tal-QSL/DDS_PCB/RF sim files/Sim/FrequencyResponse.jpg

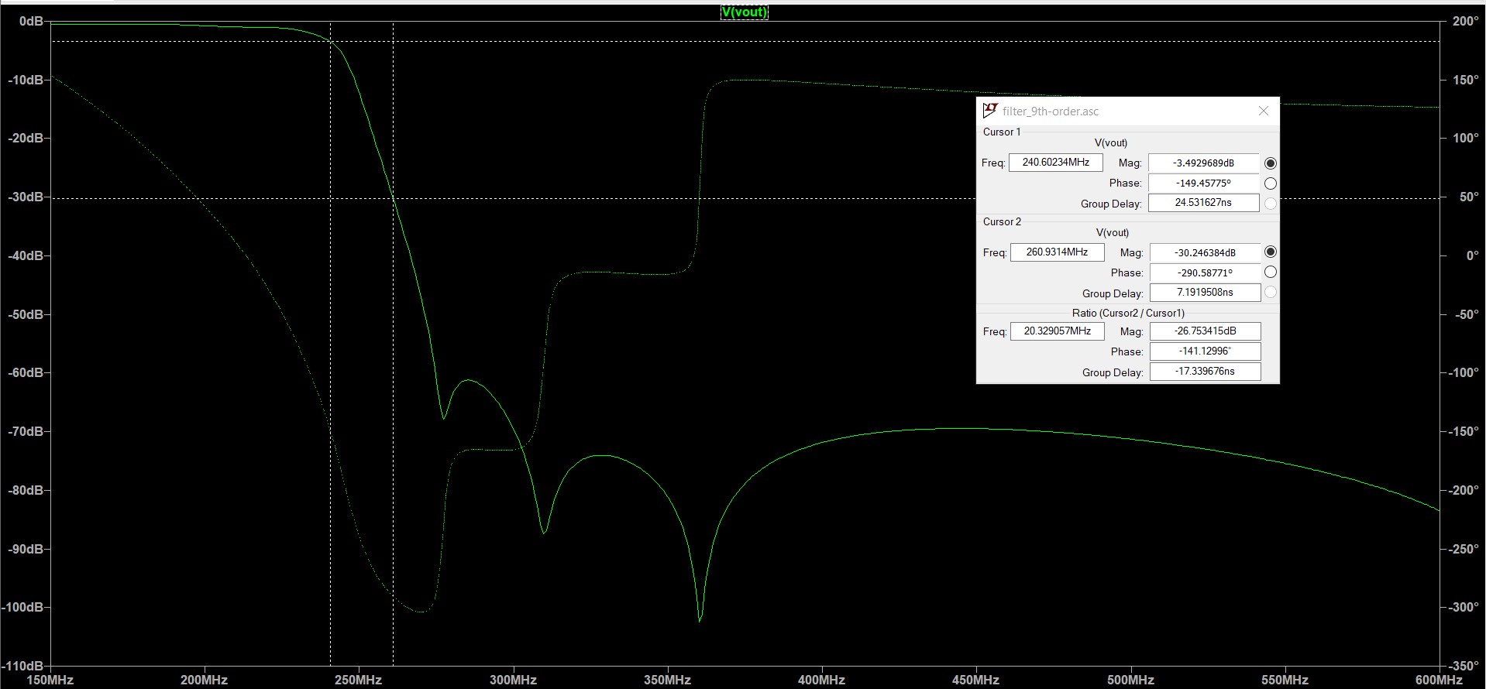
RF sim files/Sim/FrequencyResponse.jpg
