tal-QSL/DDS_PCB/DDS_PCB_BOM.xlsx

Designator | Quantity | Value | Name | Description | Footprint | Manufacturer 1 | Manufacturer Part Number 1 | Manufacturer Lifecycle 1 | Supplier 1 | Supplier Part Number 1 | Supplier Unit Price 1 | Supplier Subtotal 1
C1_M1, C1_M2 | 2 |  | 680pF 50V | CAP CER 680PF 50V NP0 0402 | C0402
C2_M1, C2_M2, C3_M1, C3_M2 | 4 |  | 39pF 50V | CAP CER 39PF 50V NP0 0402 | C0402
C4_M1, C4_M2, C5_M1, C5_M2, C6_M1, C6_M2, C31_A1, C31_A2, C31_A3, C31_A4, C31_A5, C31_A6, C31_A7, C31_A8, C32_A1, C32_A2, C32_A3, C32_A4, C32_A5, C32_A6, C32_A7, C32_A8, C40_A1, C40_A2, C40_A3, C40_A4, C40_A5, C40_A6, C40_A7, C40_A8 | 30 |  | 1uF 25V | CAP CER 1uF 25V X5R 0402 | C0402
C7_M1, C7_M2, C8_M1, C8_M2, C9_M1, C9_M2, C43_M1, C43_M2, C59_M1, C59_M2, C62_M1, C62_M2, C65_M1, C65_M2 | 14 |  | 10uF 10V | CAP CER 10uF 10V X5R 0402 | C0402
C10_M1, C10_M2, C11_M1, C11_M2, C12_M1, C12_M2, C29_LS1, C29_LS2, C29_LS3, C29_LS4, C30_LS1, C30_LS2, C30_LS3, C30_LS4, C38_A1, C38_A2, C38_A3, C38_A4, C38_A5, C38_A6, C38_A7, C38_A8, C39_A1, C39_A2, C39_A3, C39_A4, C39_A5, C39_A6, C39_A7, C39_A8, C41_M1, C41_M2, C42_M1, C42_M2, C57_M1, C57_M2, C58_M1, C58_M2, C60_M1, C60_M2, C61_M1, C61_M2, C63_M1, C63_M2, C64_M1, C64_M2 | 46 |  | 0.1uF 50V | CAP CER 0.1uF 50V NP0 0402 | C0402
C13, C20, C26 | 3 |  | 10uF 25V | CAP CER 10UF 25V 10% X5R 0603 | C0603
C14, C15, C18, C19, C22, C24, C25 | 7 |  | 10nF 25V | CAP CER 10nF 25V 10% X5R 0402 | C0402
C16, C17, C23, C27 | 4 |  | 22uF 16V | CAP CER 22UF 16V 10% X5R 0603 | C0603
C33_A1, C33_A2, C33_A3, C33_A4, C33_A5, C33_A6, C33_A7, C33_A8 | 8 |  | 16pF 50V | CAP CER 16PF 50V 5% NP0 0402 | C0402
C34_A1, C34_A2, C34_A3, C34_A4, C34_A5, C34_A6, C34_A7, C34_A8 | 8 |  | 11pF 50V | CAP CER 11PF 50V 5% NP0 0402 | C0402
C35_A1, C35_A2, C35_A3, C35_A4, C35_A5, C35_A6, C35_A7, C35_A8 | 8 |  | 10pF 50V | CAP CER 10PF 50V 5% NP0 0402 | C0402
C36_A1, C36_A2, C36_A3, C36_A4, C36_A5, C36_A6, C36_A7, C36_A8 | 8 |  | 13pF 50V | CAP CER 13PF 50V 5% NP0 0402 | C0402
C37_A1, C37_A2, C37_A3, C37_A4, C37_A5, C37_A6, C37_A7, C37_A8 | 8 |  | 470pF 25V | CAP CER 470pF 25V X5R 0402 | C0402
F1, F2, F3 | 3 |  | PTC 24V / 1.5A | FUSE PTC 24V 1.5A POLYFUSE 1812 | 1812_F
FB1_M1, FB1_M2, FB2, FB3, FB4, FB5 | 6 |  | BLM18EG221SN1D | FERRITE BEAD 220_OHM@100MHz 0603 2A 50mohm_DC | fb0603
FB6_A1, FB6_A2, FB6_A3, FB6_A4, FB6_A5, FB6_A6, FB6_A7, FB6_A8 | 8 |  | BLM15HD182 | FERRITE BEAD 1.8K OHM 0402 1LN | 0402-A
J1 | 1 |  | 1053141204 | No Description Available | CON_1053141204
J2 | 1 |  | 5767096-1 | CONN MICTOR 38POS .025 VERT SMD | MICTOR-38_PIN
J3, J4, J5 | 3 |  | 90131-0770 | CONN HEADER 20 TH | HEADER_10x2
J6 | 1 |  | 10018784-10201TLF | 64 Position Female Connector PCI Expressâ„¢ Gold 0.039 _1.00mm_ Black | PCIE_8LANE_EDGE
J7_A1, J7_A2, J7_A3, J7_A4, J7_A5, J7_A6, J7_A7, J7_A8 | 8 |  | SMA-J-P-H-RA-TH1 | No Description Available | CONN_SMA-J-P-H-RA-TH1_SAI
J8_A1, J8_A2, J8_A3, J8_A4, J8_A5, J8_A6, J8_A7, J8_A8 | 8 |  | MMCX-J-P-H-ST-TH1 | MMCX STRAIGHT, THROUGH HOLE JACK- 50 OHM | SAMTEC_MMCX-J-P-H-ST-TH1
L1_A1, L1_A2, L1_A3, L1_A4, L1_A5, L1_A6, L1_A7, L1_A8 | 8 | 56nH | Inductor | Inductor | 0402-A
L2_A1, L2_A2, L2_A3, L2_A4, L2_A5, L2_A6, L2_A7, L2_A8, L3_A1, L3_A2, L3_A3, L3_A4, L3_A5, L3_A6, L3_A7, L3_A8 | 16 | 43nH | Inductor | Inductor | 0402-A
L4_A1, L4_A2, L4_A3, L4_A4, L4_A5, L4_A6, L4_A7, L4_A8 | 8 | 47nH | Inductor | Inductor | 0402-A
L5_A1, L5_A2, L5_A3, L5_A4, L5_A5, L5_A6, L5_A7, L5_A8, L7_A1, L7_A2, L7_A3, L7_A4, L7_A5, L7_A6, L7_A7, L7_A8 | 16 | 33nH | Inductor | Inductor | 0402-A
L6_A1, L6_A2, L6_A3, L6_A4, L6_A5, L6_A6, L6_A7, L6_A8 | 8 | 24nH | Inductor | Inductor | 0402-A
L8_A1, L8_A2, L8_A3, L8_A4, L8_A5, L8_A6, L8_A7, L8_A8 | 8 | 15nH | Inductor | Inductor | 0402-A
L9_A1, L9_A2, L9_A3, L9_A4, L9_A5, L9_A6, L9_A7, L9_A8 | 8 | 3.9nH | Inductor | Inductor | 0402-A
LD1, LD2 | 2 |  | APT1608SGC | LED 1.6X0.8MM 568NM GRN CLR SMD | LED_0603_Green
Lp1 | 1 |  | NR6028T100M | INDUCTOR 10UH 1.9A 20% SMD | ind6x6_H3
R1_M1, R1_M2 | 2 |  | 6.8K | RES 6.8K OHM 1/16W 1% 0402 | R0402
R2_M1, R2_M2, R8_M1, R8_M2, R9_M1, R9_M2, R33 | 7 |  | 0R | RES 0 OHM 1/10W 1% 0402 SMD | R0402
R3_M1, R3_M2, R4_M1, R4_M2, R5_M1, R5_M2, R6_M1, R6_M2, R11_M1, R11_M2, R12_M1, R12_M2, R13_M1, R13_M2, R14_M1, R14_M2 | 16 |  | 10K | RES 10K OHM 1/16W 1% 0402 | R0402
R15_M1, R15_M2, R16_M1, R16_M2, R17_M1, R17_M2, R18_M1, R18_M2, R19_M1, R19_M2, R20_M1, R20_M2, R21_M1, R21_M2, R22_M1, R22_M2, R23_M1, R23_M2, R24_M1, R24_M2, R25_M1, R25_M2, R26_M1, R26_M2 | 24 |  | 0R | RES 0 OHM 1/8W 1% 0805 SMD | R0805
R27, R30 | 2 |  | 124K | RES 124K OHM 1/10W 1% 0402 SMD | R0402
R28, R31 | 2 |  | 1K | RES 1K OHM 1/16W 1% 0402 | R0402
R29 | 1 |  | 39.2K | RES 39.2K OHM 1/10W 1% 0402 SMD | R0402
R32, R34_LS1, R34_LS2, R34_LS3, R34_LS4 | 5 |  | 100K | RES 100K OHM 1/16W 1% 0402 | R0402
R36_A1, R36_A2, R36_A3, R36_A4, R36_A5, R36_A6, R36_A7, R36_A8, R37_A1, R37_A2, R37_A3, R37_A4, R37_A5, R37_A6, R37_A7, R37_A8 | 16 |  | 34.8R | RES 34.8 OHM 1/10W 1% 0402 SMD | r0402
R38_A1, R38_A2, R38_A3, R38_A4, R38_A5, R38_A6, R38_A7, R38_A8 | 8 |  | 18.2R | RES 18.2 OHM 1/10W 1% 0402 SMD | r0402
R39_M1, R39_M2, R40_M1, R40_M2, R50_M1, R50_M2, R51_M1, R51_M2, R52_M1, R52_M2, R53_M1, R53_M2, R54_M1, R54_M2, R55_M1, R55_M2 | 16 |  | 24.9R | RES 24.9 OHM 1/10W 1% 0402 SMD | R0402
R42_A1, R42_A2, R42_A3, R42_A4, R42_A5, R42_A6, R42_A7, R42_A8 | 8 |  | 4.7R | RES 18.2 OHM 1/10W 1% 0402 SMD | r0402
SH1_A1, SH1_A2, SH1_A3, SH1_A4, SH1_A5, SH1_A6, SH1_A7, SH1_A8 | 8 |  | G-0300SB1000-0100XC | RF Shield Cover 0.300" (7.62mm) X 1.000" (25.40mm) Non-Vented Surface Mount | RF_Sh
T1_M1, T1_M2, T3_M1, T3_M2, T4_M1, T4_M2, T5_M1, T5_M2 | 8 |  | ADTT1-1+ | No Description Available | CD542_MNC
TP1~TP7 | 7 |  |  | TP PC MINIATURE SMT | TP_2x1.8
U1_M1, U1_M2 | 2 |  | AD9959BCPZ | No Description Available | CP_56_1_ADI
U2, U3 | 2 |  | MUN12AD03-SEC | No Description Available | SO8_MUN12AD_DEA
U4_LS1, U4_LS2, U4_LS3, U4_LS4 | 4 |  | 74AVC4T774_GU |  | NXP_74AVC4T245GU,115
U5_A1, U5_A2, U5_A3, U5_A4, U5_A5, U5_A6, U5_A7, U5_A8 | 8 |  | BGA2815,115 | No Description Available | SOT_2815,115_NXP
U6_A1, U6_A2, U6_A3, U6_A4, U6_A5, U6_A6, U6_A7, U6_A8 | 8 |  | ADG901BCPZ-500RL7 | No Description Available | CP_8_2_ADI
Y1_M1, Y1_M2 | 2 |  | ECS-250-20-33-CKM-TR3 | No Description Available | SMD4_ECX-32_3p2x2p5_ECS
