tal-QSL/DDS_PCB/2023-04-04T081156.xlsx

Index | Quantity | Part Number | Manufacturer Part Number | Description | Customer Reference | Available | Backorder | Unit Price | Extended Price USD
1 | 50 | 1276-1717-6-ND | CL05C681JB5NNNC | CAP CER 680PF 50V C0G/NP0 0402 |  | 50 | 0 | 0.1568 | 7.84
2 | 50 | 478-1077-6-ND | 04025A390JAT2A | CAP CER 39PF 50V C0G/NP0 0402 |  | 50 | 0 | 0.1552 | 7.76
3 | 1000 | 1276-CL05B104KB54PNCDKR-ND | CL05B104KB54PNC | CAP CER 0.1UF 50V X7R 0402 |  | 1000 | 0 | 0.01847 | 18.47
4 | 500 | 445-9066-6-ND | C1005X5R1E105K050BC | CAP CER 1UF 25V X5R 0402 |  | 500 | 0 | 0.0488 | 24.40
5 | 100 | 1276-1139-6-ND | CL05C100JB5NNNC | CAP CER 10PF 50V C0G/NP0 0402 |  | 100 | 0 | 0.0823 | 8.23
6 | 50 | 490-GRM188R61E106KA73JDKR-ND | GRM188R61E106KA73J | CAP CER 10UF 25V X5R 0603 |  | 50 | 0 | 0.2564 | 12.82
7 | 100 | 399-C0402C103K5RECAUTODKR-ND | C0402C103K5RECAUTO | CAP CER 0402 10NF 50V X7R 10% |  | 100 | 0 | 0.1196 | 11.96
8 | 100 | 1276-7076-6-ND | CL10A226MO7JZNC | CAP CER 22UF 16V X5R 0603 |  | 100 | 0 | 0.3456 | 34.56
9 | 250 | 4587-C0402B106M010TDKR-ND | C0402B106M010T | CAP CER 10UF 10V X5R 0402 |  | 250 | 0 | 0.1138 | 28.45
10 | 50 | F3487DKR-ND | 1812L150/24MR | PTC RESET FUSE 24V 1.5A 1812 |  | 50 | 0 | 0.6506 | 32.53
11 | 100 | 490-3992-6-ND | BLM18EG221SN1D | FERRITE BEAD 220 OHM 0603 1LN |  | 100 | 0 | 0.1734 | 17.34
12 | 100 | SAM8856-ND | SMA-J-P-H-RA-TH1 | CONN SMA JACK R/A 50 OHM PCB |  | 100 | 0 | 6.35188 | 635.19
13 | 15 | WM14976-ND | 1053141204 | CONN HEADER R/A 4POS 2.5MM |  | 15 | 0 | 1.389 | 20.84
14 | 15 | WM14962-ND | 1053081204 | CONN RCPT HSG 4POS 2.50MM |  | 15 | 0 | 0.379 | 5.69
15 | 100 | WM15011CT-ND | 1053002300 | CONN 20-22AWG CRIMP GOLD |  | 100 | 0 | 0.2246 | 22.46
16 | 15 | A136332DKR-ND | 5767096-1 | CONN RCPT 38POS SMD GOLD |  | 15 | 0 | 16.9 | 253.50
17 | 100 | SAM10617-ND | MMCX-J-P-H-ST-TH1 | CONN MMCX JACK STR 50 OHM PCB |  | 100 | 0 | 4.0602 | 406.02
18 | 45 | WM8146-ND | 0901310770 | CONN HEADER VERT 20POS 2.54MM |  | 45 | 0 | 4.177 | 187.97
19 | 100 | 732-74478447DKR-ND | 74478447 | FIXED IND 47NH 150MA 1.3 OHM SMD |  | 100 | 0 | 0.111 | 11.10
20 | 250 | 490-2629-6-ND | LQG15HS33NJ02D | FIXED IND 33NH 350MA 580MOHM SMD |  | 250 | 0 | 0.06048 | 15.12
21 | 100 | 490-2632-6-ND | LQG15HS56NJ02D | FIXED IND 56NH 250MA 820MOHM SMD |  | 100 | 0 | 0.1088 | 10.88
22 | 40 | 754-1121-6-ND | APT1608SGC | LED GREEN CLEAR CHIP SMD |  | 40 | 0 | 0.41 | 16.40
23 | 15 | 587-2102-6-ND | NR6028T100M | FIXED IND 10UH 1.9A 84.5MOHM SMD |  | 15 | 0 | 0.786 | 11.79
24 | 300 | P49.9LDKR-ND | ERJ-2RKF49R9X | RES SMD 49.9 OHM 1% 1/10W 0402 |  | 300 | 0 | 0.03723 | 11.17
25 | 500 | RMCF0805ZT0R00DKR-ND | RMCF0805ZT0R00 | RES 0 OHM JUMPER 1/8W 0805 |  | 500 | 0 | 0.01836 | 9.18
26 | 30 | P124KLDKR-ND | ERJ-2RKF1243X | RES SMD 124K OHM 1% 1/10W 0402 |  | 30 | 0 | 0.26733 | 8.02
27 | 20 | P39.2KLDKR-ND | ERJ-2RKF3922X | RES SMD 39.2K OHM 1% 1/10W 0402 |  | 20 | 0 | 0.384 | 7.68
28 | 100 | 1292-WR04X104JTLDKR-ND | WR04X104 JTL | RES 100K OHM 5% 1/16W 0402 |  | 100 | 0 | 0.0725 | 7.25
29 | 250 | RMCF0402ZT0R00DKR-ND | RMCF0402ZT0R00 | RES 0 OHM JUMPER 1/16W 0402 |  | 250 | 0 | 0.0312 | 7.80
30 | 30 | 13-RC0402FR-136K8LDKR-ND | RC0402FR-136K8L | RES 6.8K OHM 1% 1/16W 0402 |  | 30 | 0 | 0.24733 | 7.42
31 | 250 | YAG3436DKR-ND | AC0402FR-0710KL | RES SMD 10K OHM 1% 1/16W 0402 |  | 250 | 0 | 0.03592 | 8.98
32 | 10000 | 1292-WR04X1001FTLTR-ND | WR04X1001FTL | RES 1K OHM 1% 1/16W 0402 |  | 10000 | 0 | 0.00073 | 7.30
33 | 100 | A106145DKR-ND | RCU-0C | PC TEST POINT NATURAL |  | 100 | 0 | 0.2435 | 24.35
34 | 20 | 505-AD9959BCPZ-ND | AD9959BCPZ | IC DDS 500MHZ 10BIT 56LFCSP |  | 20 | 0 | 83.41 | 1668.20
35 | 25 | 2037-MUN12AD03-SECDKR-ND | MUN12AD03-SEC | DC DC CONVERTER 0.8-5.5V |  | 25 | 0 | 6.1704 | 154.26
36 | 100 | 505-ADG901BCPZ-500RL7DKR-ND | ADG901BCPZ-500RL7 | IC RF SWITCH SPST 2.5GHZ 8LFCSP |  | 100 | 0 | 2.956 | 295.60
37 | 100 | 568-6209-6-ND | BGA2815,115 | IC RF AMP GPS 0HZ-2.2GHZ 6TSSOP |  | 100 | 0 | 0.2797 | 27.97
38 | 50 | 1727-7647-6-ND | 74AVC4T774GUX | IC TRANSLTR BIDIRECTIONAL 16XQFN |  | 50 | 0 | 0.9164 | 45.82
39 | 100 | 3157-ADTT1-1+DKR-ND | ADTT1-1+ | 1:1 CORE & WIRE TRANSFORMER, 0.3 |  | 100 | 0 | 5.2322 | 523.22
40 | 30 | 50-ECS-250-20-33-CKM-TR3DKR-ND | ECS-250-20-33-CKM-TR3 | CRYSTAL 25.0000MHZ 20PF SMD |  | 30 | 0 | 0.58733 | 17.62
41 | 100 | 490-GCM1555C1H160FA16DDKR-ND | GCM1555C1H160FA16D | CAP CER 16PF 50V C0G/NP0 0402 |  | 100 | 0 | 0.1007 | 10.07
42 | 100 | 490-GCM1555C1H110FA16DDKR-ND | GCM1555C1H110FA16D | CAP CER 11PF 50V C0G/NP0 0402 |  | 100 | 0 | 0.1007 | 10.07
43 | 100 | 490-GJM1555C1H130FB01DDKR-ND | GJM1555C1H130FB01D | CAP CER 13PF 50V C0G/NP0 0402 |  | 100 | 0 | 0.1249 | 12.49
44 | 100 | 2347-G-0300SB1000-0100XC-ND | G-0300SB1000-0100XC | RF SHIELD 0.300" X 1.000" COVER |  | 100 | 0 | 6.1552 | 615.52
45 | 200 | P34.8LDKR-ND | ERJ-2RKF34R8X | RES SMD 34.8 OHM 1% 1/10W 0402 |  | 200 | 0 | 0.0489 | 9.78
46 | 100 | P18.2LDKR-ND | ERJ-2RKF18R2X | RES SMD 18.2 OHM 1% 1/10W 0402 |  | 100 | 0 | 0.0839 | 8.39
47 | 250 | 445-6314-6-ND | MLG1005S43NJT000 | FIXED IND 43NH 250MA 1.1 OHM SMD |  | 250 | 0 | 0.09828 | 24.57
48 | 100 | 445-174653-6-ND | MHQ0402PSA3N9BT000 | FIXED IND 3.9NH 200MA 750MOHM SM |  | 100 | 0 | 0.1276 | 12.76
49 | 100 | 445-6311-6-ND | MLG1005S24NJT000 | FIXED IND 24NH 350MA 700MOHM SMD |  | 100 | 0 | 0.1467 | 14.67
50 | 100 | 535-12211-6-ND | AIMC-0402HQ-15NJ-T | FIXED IND 15NH 430MA 220MOHM SMD |  | 100 | 0 | 0.2533 | 25.33
51 | 100 | 541-10415-6-ND | RCS04024R70FKED | RES SMD 4.7 OHM 1% 1/5W 0402 |  | 100 | 0 | 0.1194 | 11.94
52 | 100 | 490-5196-6-ND | BLM15HD182SN1D | FERRITE BEAD 1.8K OHM 0402 1LN |  | 100 | 0 | 0.1402 | 14.02
53 | 100 | 445-5604-6-ND | CGA2B2C0G1H471J050BA | CAP CER 470PF 50V C0G 0402 |  | 100 | 0 | 0.0967 | 9.67
54 | 300 | P24.9LDKR-ND | ERJ-2RKF24R9X | RES SMD 24.9 OHM 1% 1/10W 0402 |  | 300 | 0 | 0.03723 | 11.17
