tal-QSL/DDS_PCB/(list of files, cad)

Other CAD files:
DDS_PCB.DWG
