tal-QSL/DDS_PCB/DDS_PCB.pdf

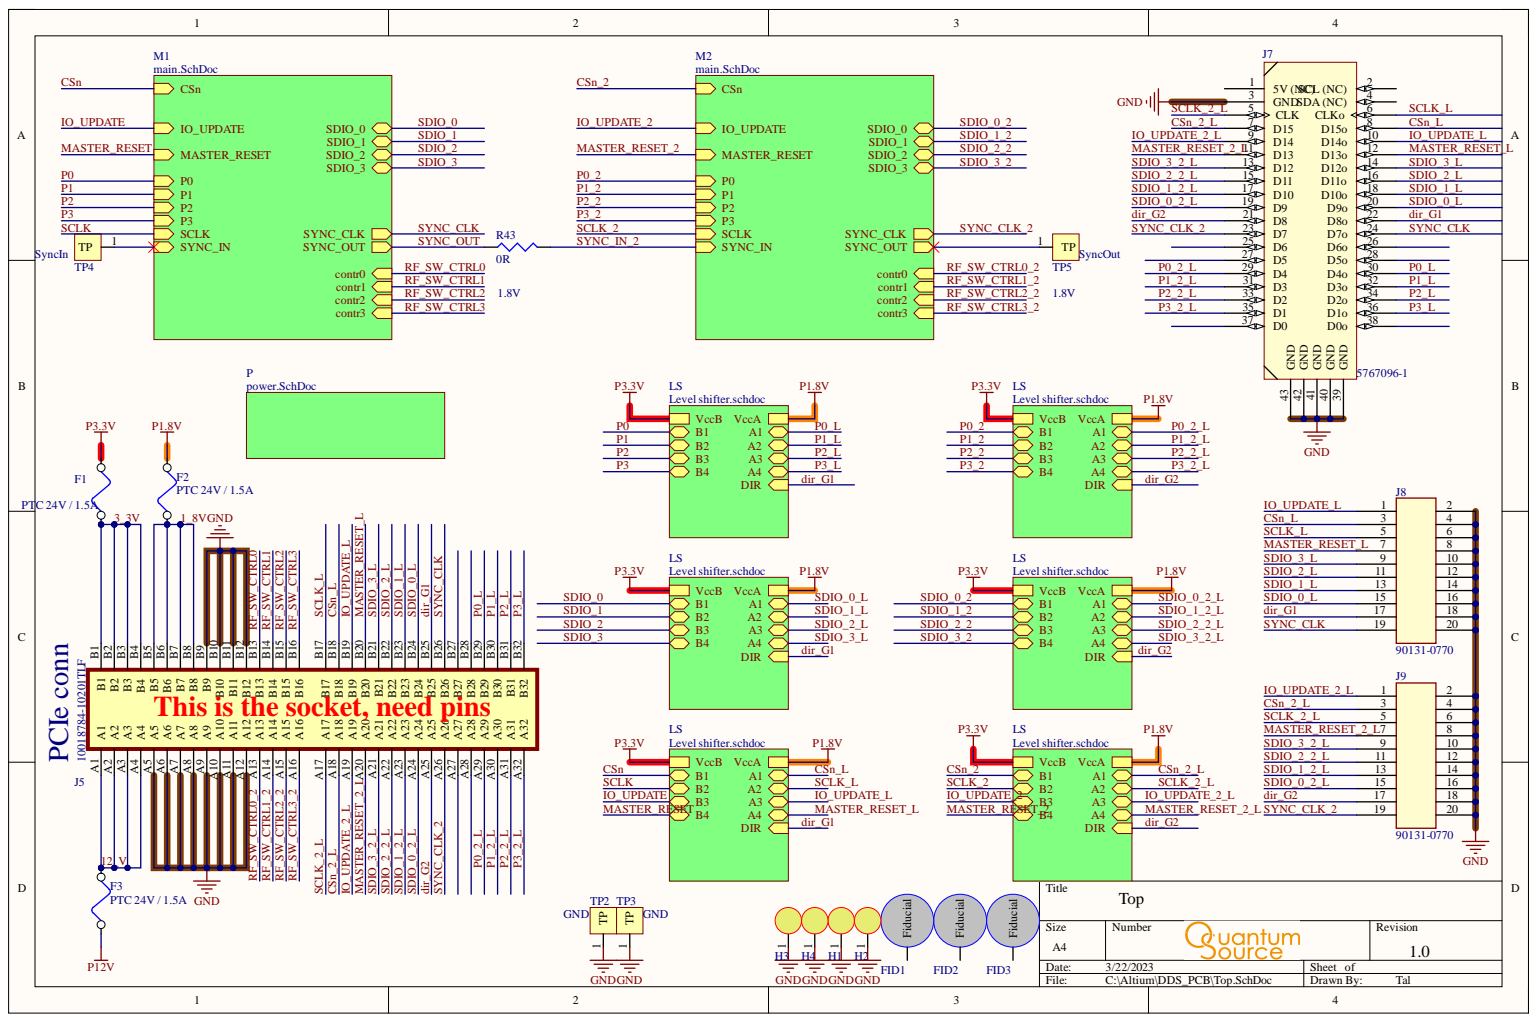
[picture p4: page 1]

GND 39 GND 40 GND 41 GND 42 GND 43

10018784-10201TLF
This is the socket, need pins

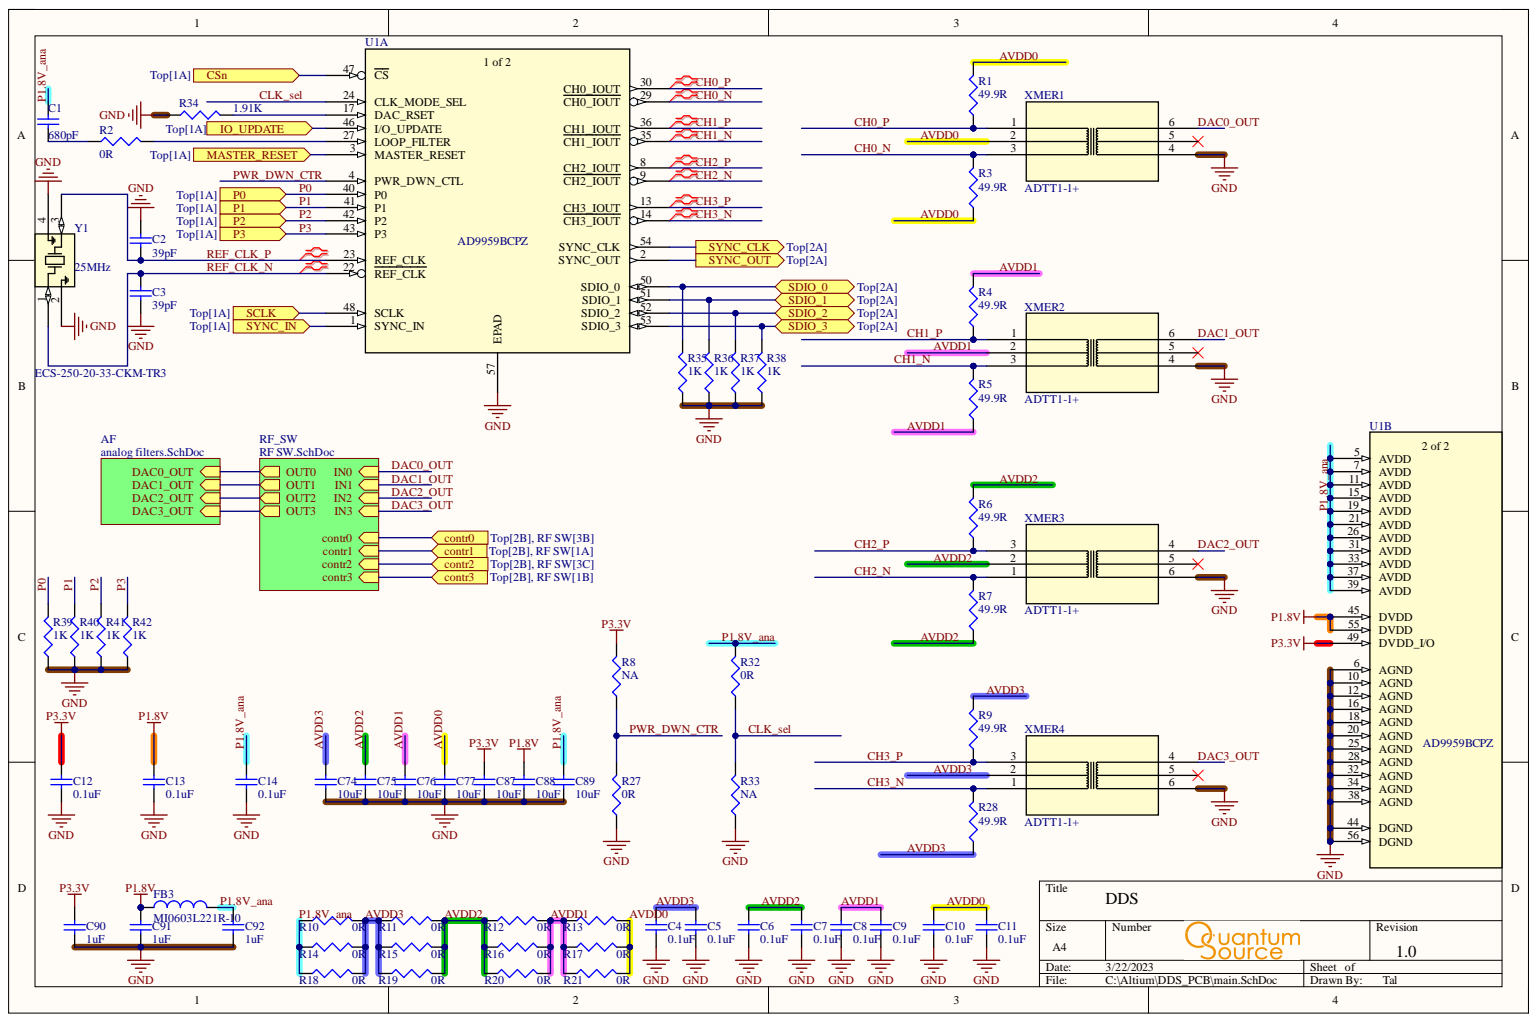
[picture p5: page 2]

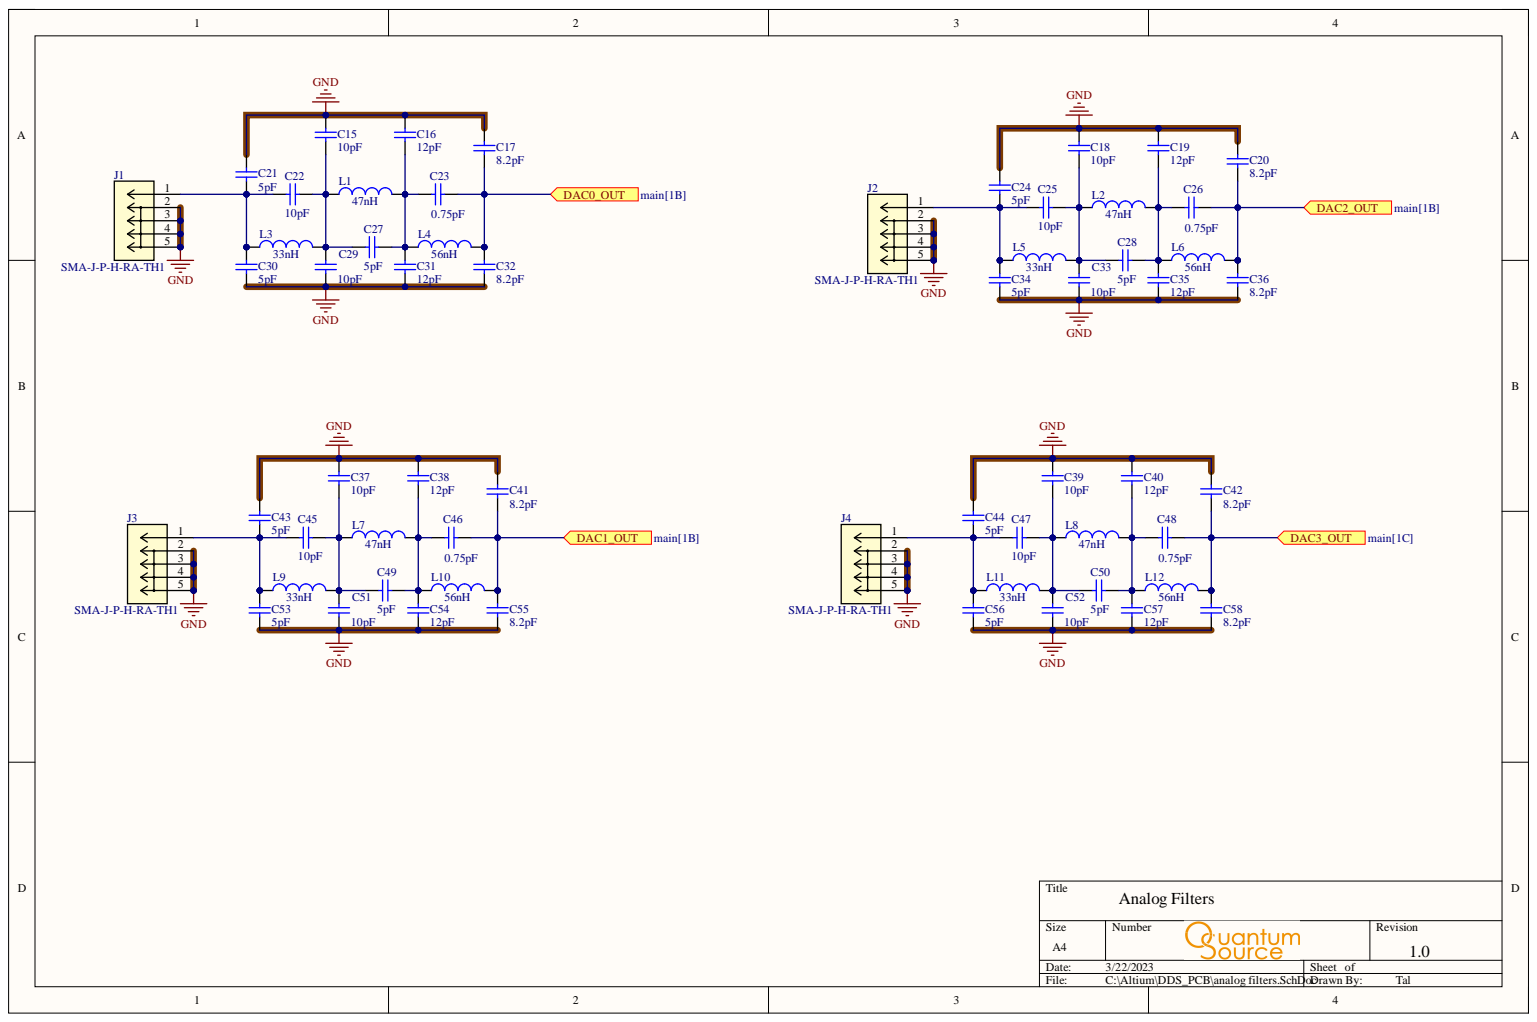
[picture p6: page 3]

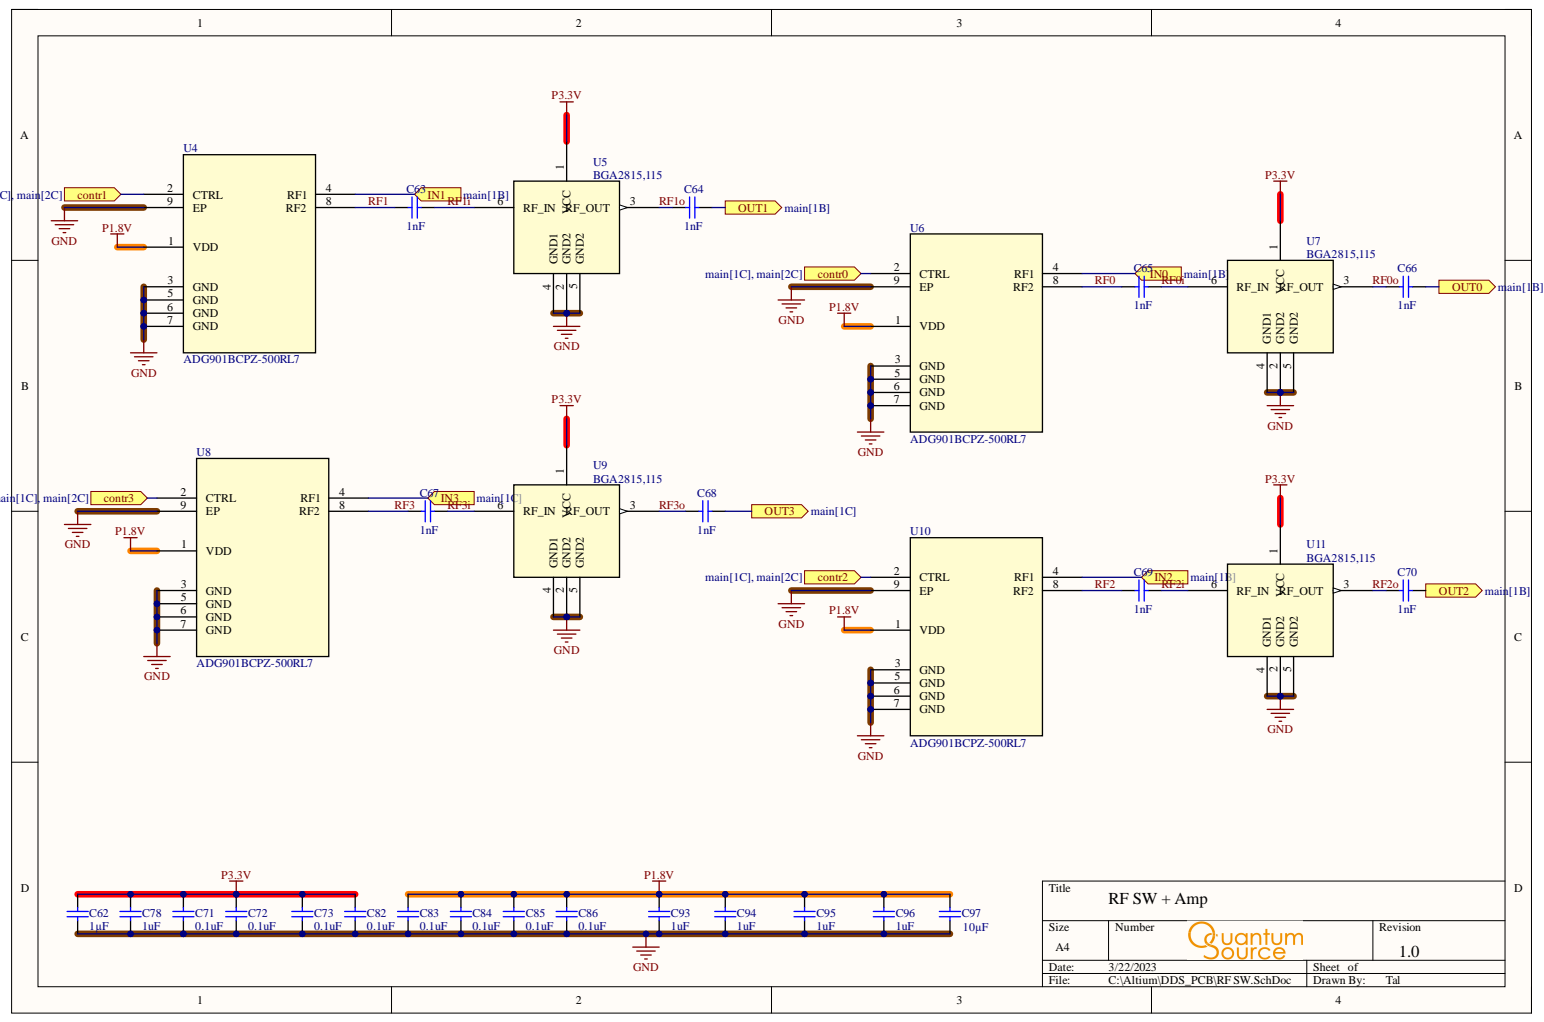
[picture p7: page 4]

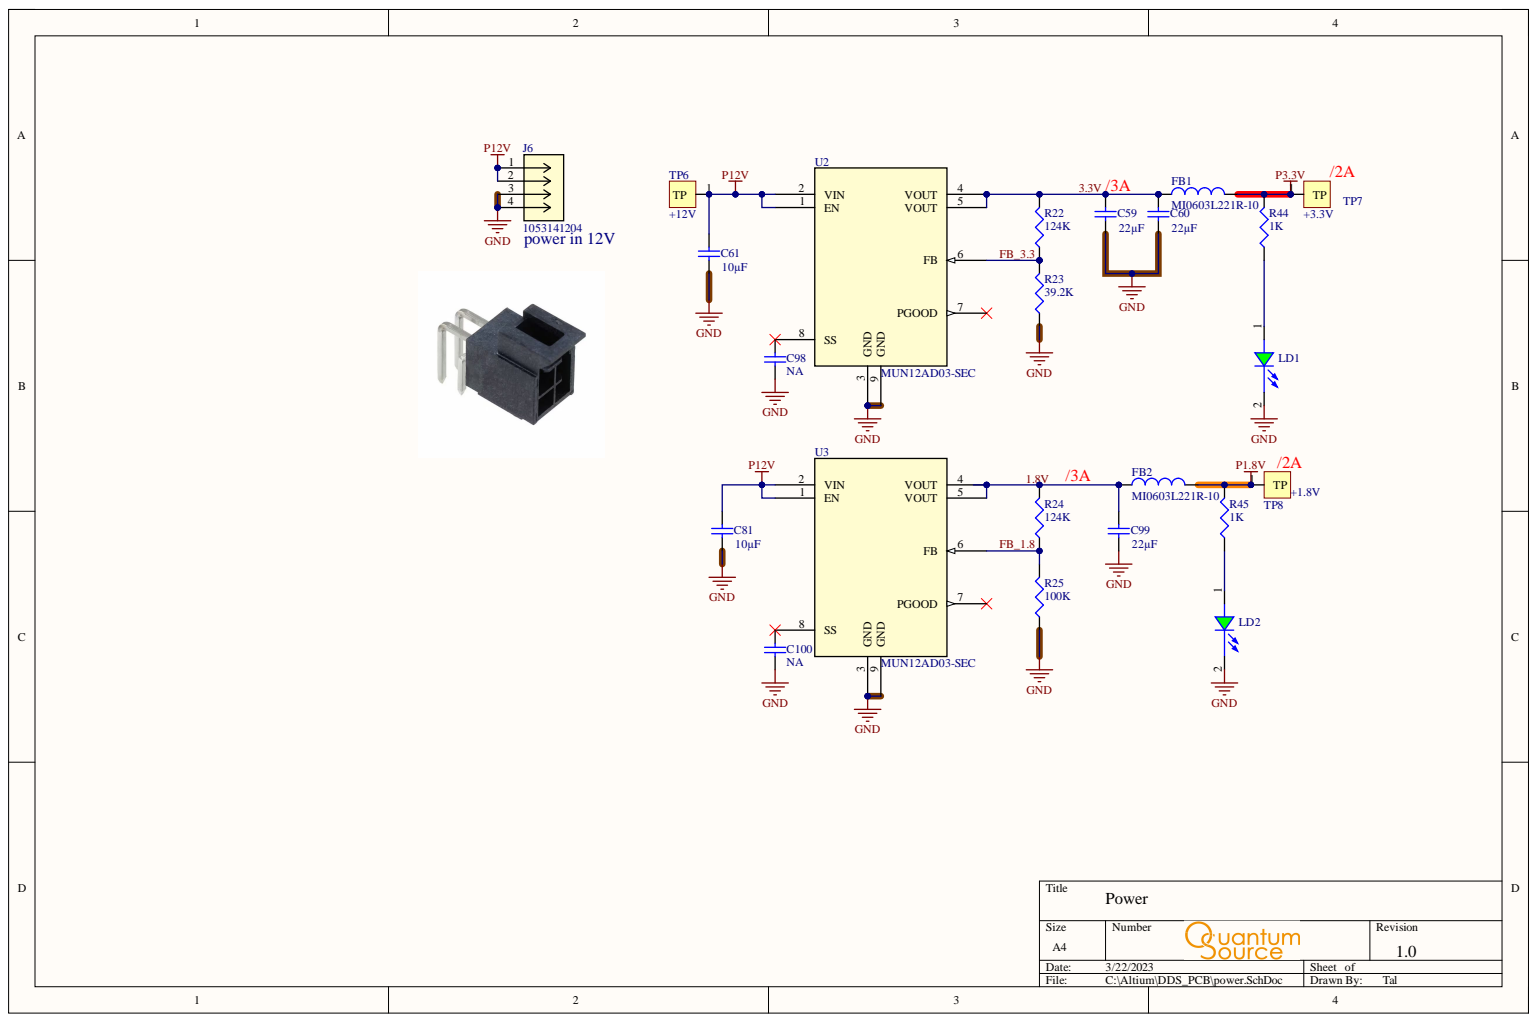
[picture p8: page 5]

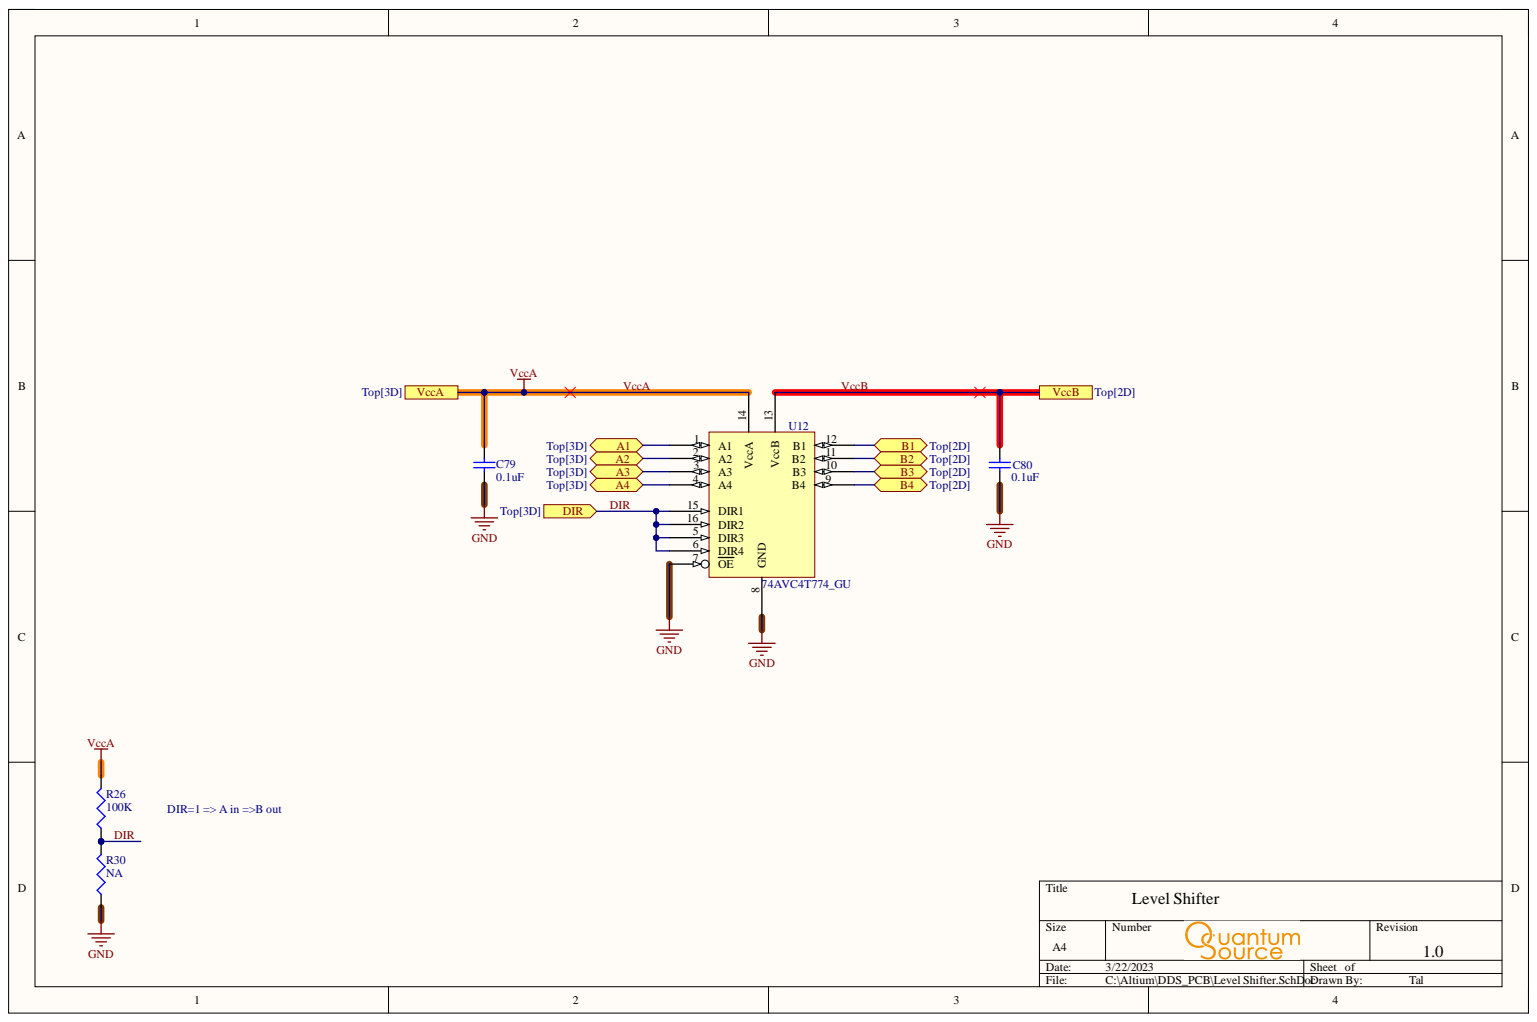
[picture p9: page 6]

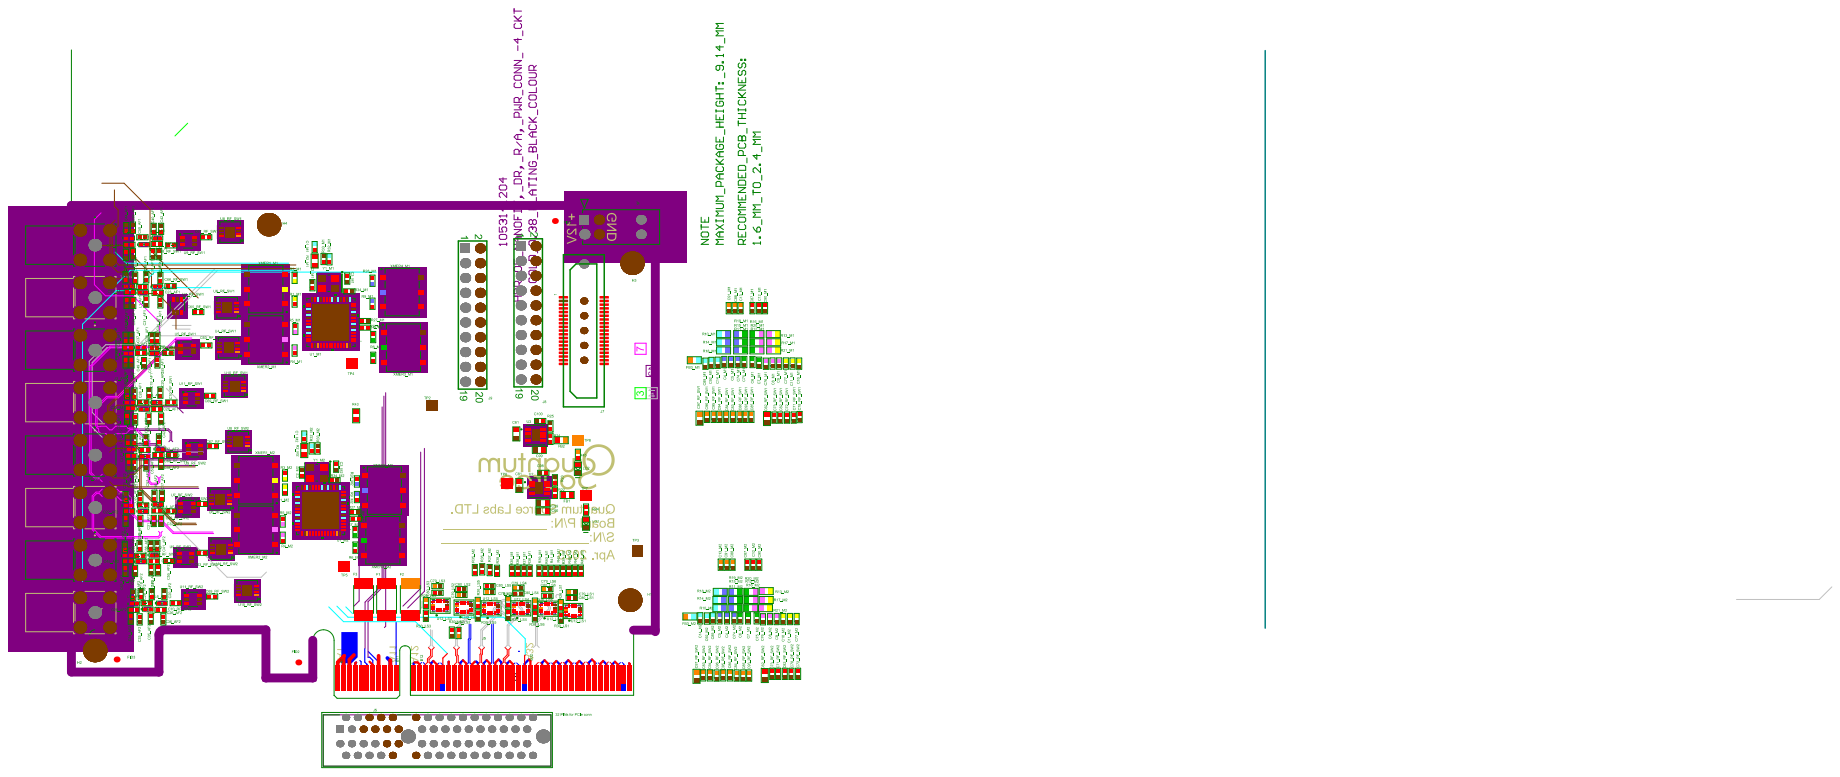
[picture p10: page 7]
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
