tal-QSL/DDS_PCB/RF sim files/Sim/filter_9th-order.asc

C2: cap; 16.00p
C4: cap; 11.00p
C6: cap; 10.00p
C8: cap; 13.00p
L1: ind; 43.00n; Rser=700m
L2: ind; 3.900n; Rser=40m
L3: ind; 56.00n; Rser=1.173
L4: ind; 24.00n; Rser=520m
L5: ind; 43.00n; Rser=700m
L6: ind; 33.00n; Rser=630m
L7: ind; 47.00n; Rser=720m
L8: ind; 15.00n; Rser=160m
L9: ind; 33.00n; Rser=630m
R1: res; 50
RL: res; 50
V1: voltage; SINE(0 1 100MEG); AC 2
Named nets: Vin, 0, Vout
.ac lin 500 150MEG 600MEG
9th Order Elliptic Lowpass
Series First
Cutoff Frequency = 243 MHz
Passband Ripple = 0.20 dB; Stopband Attenuation = 70.00 dB
0402HC-3N9ECTS
0402HM-430EGTS
0402HM-560EGTS
0402HM-430EGTS
LQG15HS47NJ02D
LQW15AN33NJ00D
LQW15AN24NJ00D
LQW15AN33NJ00D
LQW15AN15NG00D
CQ0402FRNPO9BN160
CQ0402FRNPO9BN100
CC0402JRNPO9BN110
CC0402JRNPO9BN130
