tal-QSL/DDS_PCB/(list of files, drawings)

Other design files:
09_04_2023/analog_channel3.SchDoc
09_04_2023/analog_channel.SchDoc
09_04_2023/DDS_PCB.PcbLib
09_04_2023/DDS_PCB.PrjPcb
09_04_2023/DDS_PCB_1.SCHLIB
09_04_2023/Level Shifter.SchDoc
09_04_2023/main.SchDoc
09_04_2023/power.SchDoc
09_04_2023/Top.SchDoc
analog_channel3.SchDoc
analog_channel.SchDoc
DDS_PCB1.PcbLib
DDS_PCB.PcbLib
DDS_PCB.PrjPcb
DDS_PCB.SCHLIB
main.SchDoc
old/03_04_2023/analog_channel.SchDoc
old/03_04_2023/DDS_PCB.PcbLib
old/03_04_2023/DDS_PCB.PrjPcb
old/03_04_2023/DDS_PCB_1.SCHLIB
old/03_04_2023/ISO A3_QS-Labs.SchDoc
old/03_04_2023/ISO A4_QS-Labs.SchDoc
old/03_04_2023/Level Shifter.SchDoc
old/03_04_2023/main.SchDoc
old/03_04_2023/power.SchDoc
old/03_04_2023/Top.SchDoc
old/04_04_2023/analog_channel.SchDoc
old/04_04_2023/Level Shifter.SchDoc
old/04_04_2023/main.SchDoc
old/04_04_2023/power.SchDoc
old/04_04_2023/Top.SchDoc
old/files from Editor/03_04_2023/analog_channel - old.SchDoc
old/files from Editor/03_04_2023/analog_channel.SchDoc
old/files from Editor/03_04_2023/DDS_PCB.PcbLib
old/files from Editor/03_04_2023/DDS_PCB.PrjPcb
old/files from Editor/03_04_2023/DDS_PCB_1.SCHLIB
old/files from Editor/03_04_2023/Level Shifter.SchDoc
old/files from Editor/03_04_2023/main.SchDoc
old/files from Editor/03_04_2023/power.SchDoc
old/files from Editor/03_04_2023/Top.SchDoc
old/files from Editor/03_04_2023b/analog_channel.SchDoc
old/files from Editor/03_04_2023b/DDS_PCB.PcbLib
old/files from Editor/03_04_2023b/DDS_PCB.PrjPcb
old/files from Editor/03_04_2023b/DDS_PCB_1.SCHLIB
old/files from Editor/03_04_2023b/Level Shifter.SchDoc
old/files from Editor/03_04_2023b/main.SchDoc
old/files from Editor/03_04_2023b/power.SchDoc
old/files from Editor/03_04_2023b/Top.SchDoc
old/files from Editor/03_04_2023c/analog_channel3.SchDoc
old/files from Editor/03_04_2023c/analog_channel.SchDoc
old/files from Editor/03_04_2023c/DDS_PCB.PcbLib
old/files from Editor/03_04_2023c/DDS_PCB.PrjPcb
old/files from Editor/03_04_2023c/DDS_PCB_1.SCHLIB
old/files from Editor/03_04_2023c/Level Shifter.SchDoc
old/files from Editor/03_04_2023c/main.SchDoc
old/files from Editor/03_04_2023c/power.SchDoc
old/files from Editor/03_04_2023c/Top.SchDoc
old/files from Editor/03_04_2023d/analog_channel3.SchDoc
old/files from Editor/03_04_2023d/analog_channel.SchDoc
old/files from Editor/03_04_2023d/DDS_PCB.PcbLib
old/files from Editor/03_04_2023d/DDS_PCB.PrjPcb
old/files from Editor/03_04_2023d/DDS_PCB_1.SCHLIB
old/files from Editor/03_04_2023d/Level Shifter.SchDoc
old/files from Editor/03_04_2023d/main.SchDoc
old/files from Editor/03_04_2023d/power.SchDoc
old/files from Editor/03_04_2023d/Top.SchDoc
old/files from Editor/old/analog_channel.SchDoc
old/files from Editor/old/DDS_PCB1.PcbLib
old/files from Editor/old/DDS_PCB.PcbLib
old/files from Editor/old/DDS_PCB.PrjPcb
old/files from Editor/old/DDS_PCB_1.SCHLIB
old/files from Editor/old/Level Shifter.SchDoc
old/files from Editor/old/main.SchDoc
old/files from Editor/old/old2/analog_channel3.SchDoc
old/files from Editor/old/old2/analog_channel.SchDoc
old/files from Editor/old/old2/DDS_PCB1.PcbLib
old/files from Editor/old/old2/DDS_PCB.PrjPcb
old/files from Editor/old/old2/DDS_PCB_1.SCHLIB
old/files from Editor/old/old2/Level Shifter.SchDoc
old/files from Editor/old/old2/main.SchDoc
old/files from Editor/old/old2/power.SchDoc
old/files from Editor/old/old2/Top.SchDoc
old/files from Editor/old/power.SchDoc
old/files from Editor/old/Top.SchDoc
old/files from Editor/temp/analog_channel3.SchDoc
old/files from Editor/temp/analog_channel.SchDoc
old/files from Editor/temp/DDS_PCB.PcbLib
old/files from Editor/temp/DDS_PCB.PrjPcb
old/files from Editor/temp/DDS_PCB_1.SCHLIB
old/files from Editor/temp/Level Shifter.SchDoc
old/files from Editor/temp/main.SchDoc
old/files from Editor/temp/power.SchDoc
old/files from Editor/temp/Top.SchDoc
power.SchDoc
RF sim files/LPF_240MHz/Filter_240MHz.SchDoc
RF sim files/LPF_240MHz/LPF.PcbDoc
RF sim files/LPF_240MHz/LPF.PrjPcb
Top.SchDoc
